Danjovic/CP297s/README.md

# CP297s
ZX97 lite board for CP200s case
