Danjovic/CP297s/CP297s-components-map.pdf

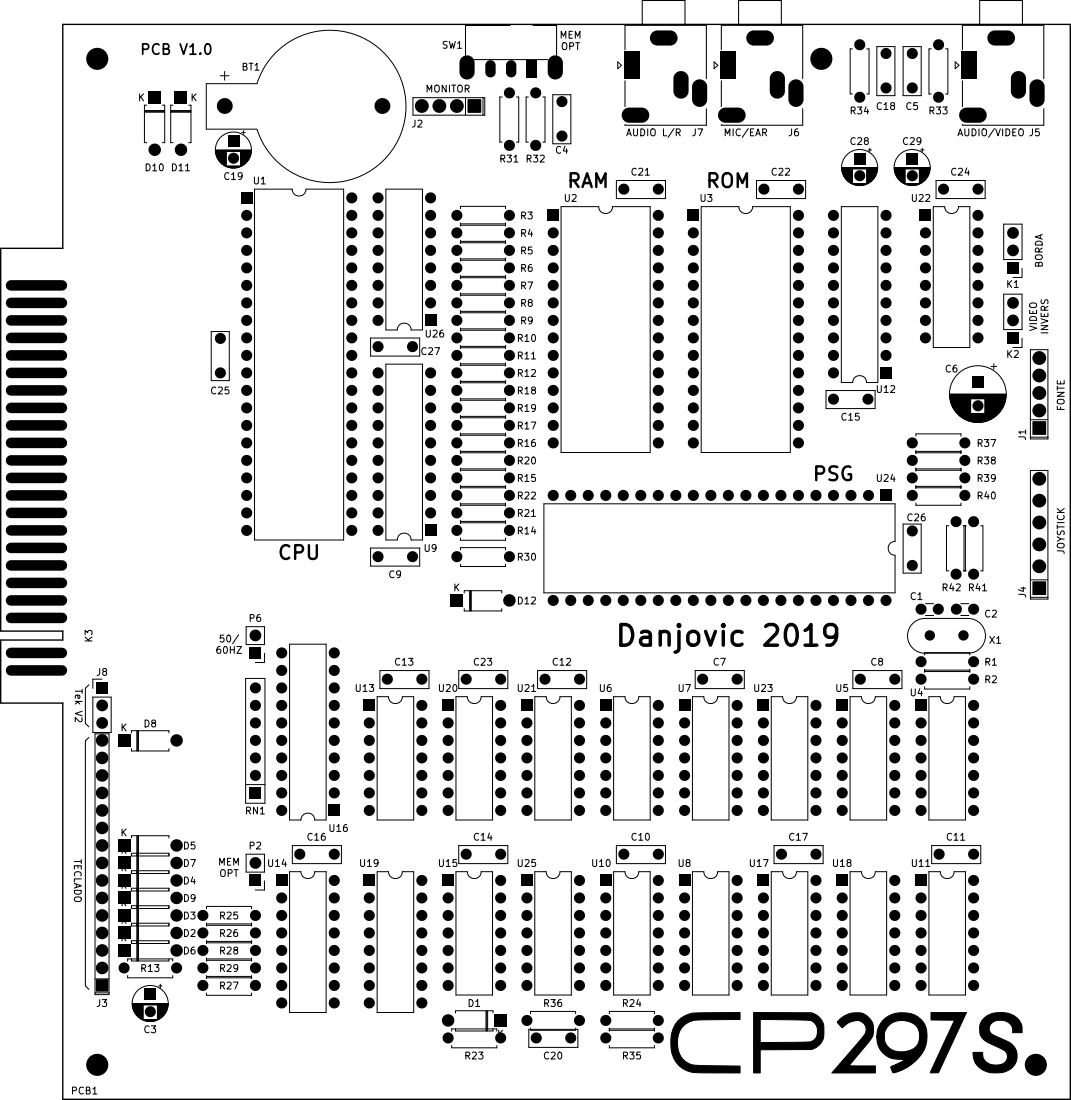
[picture p1: page 1]
