Danjovic/CP297s/CP297s.pdf

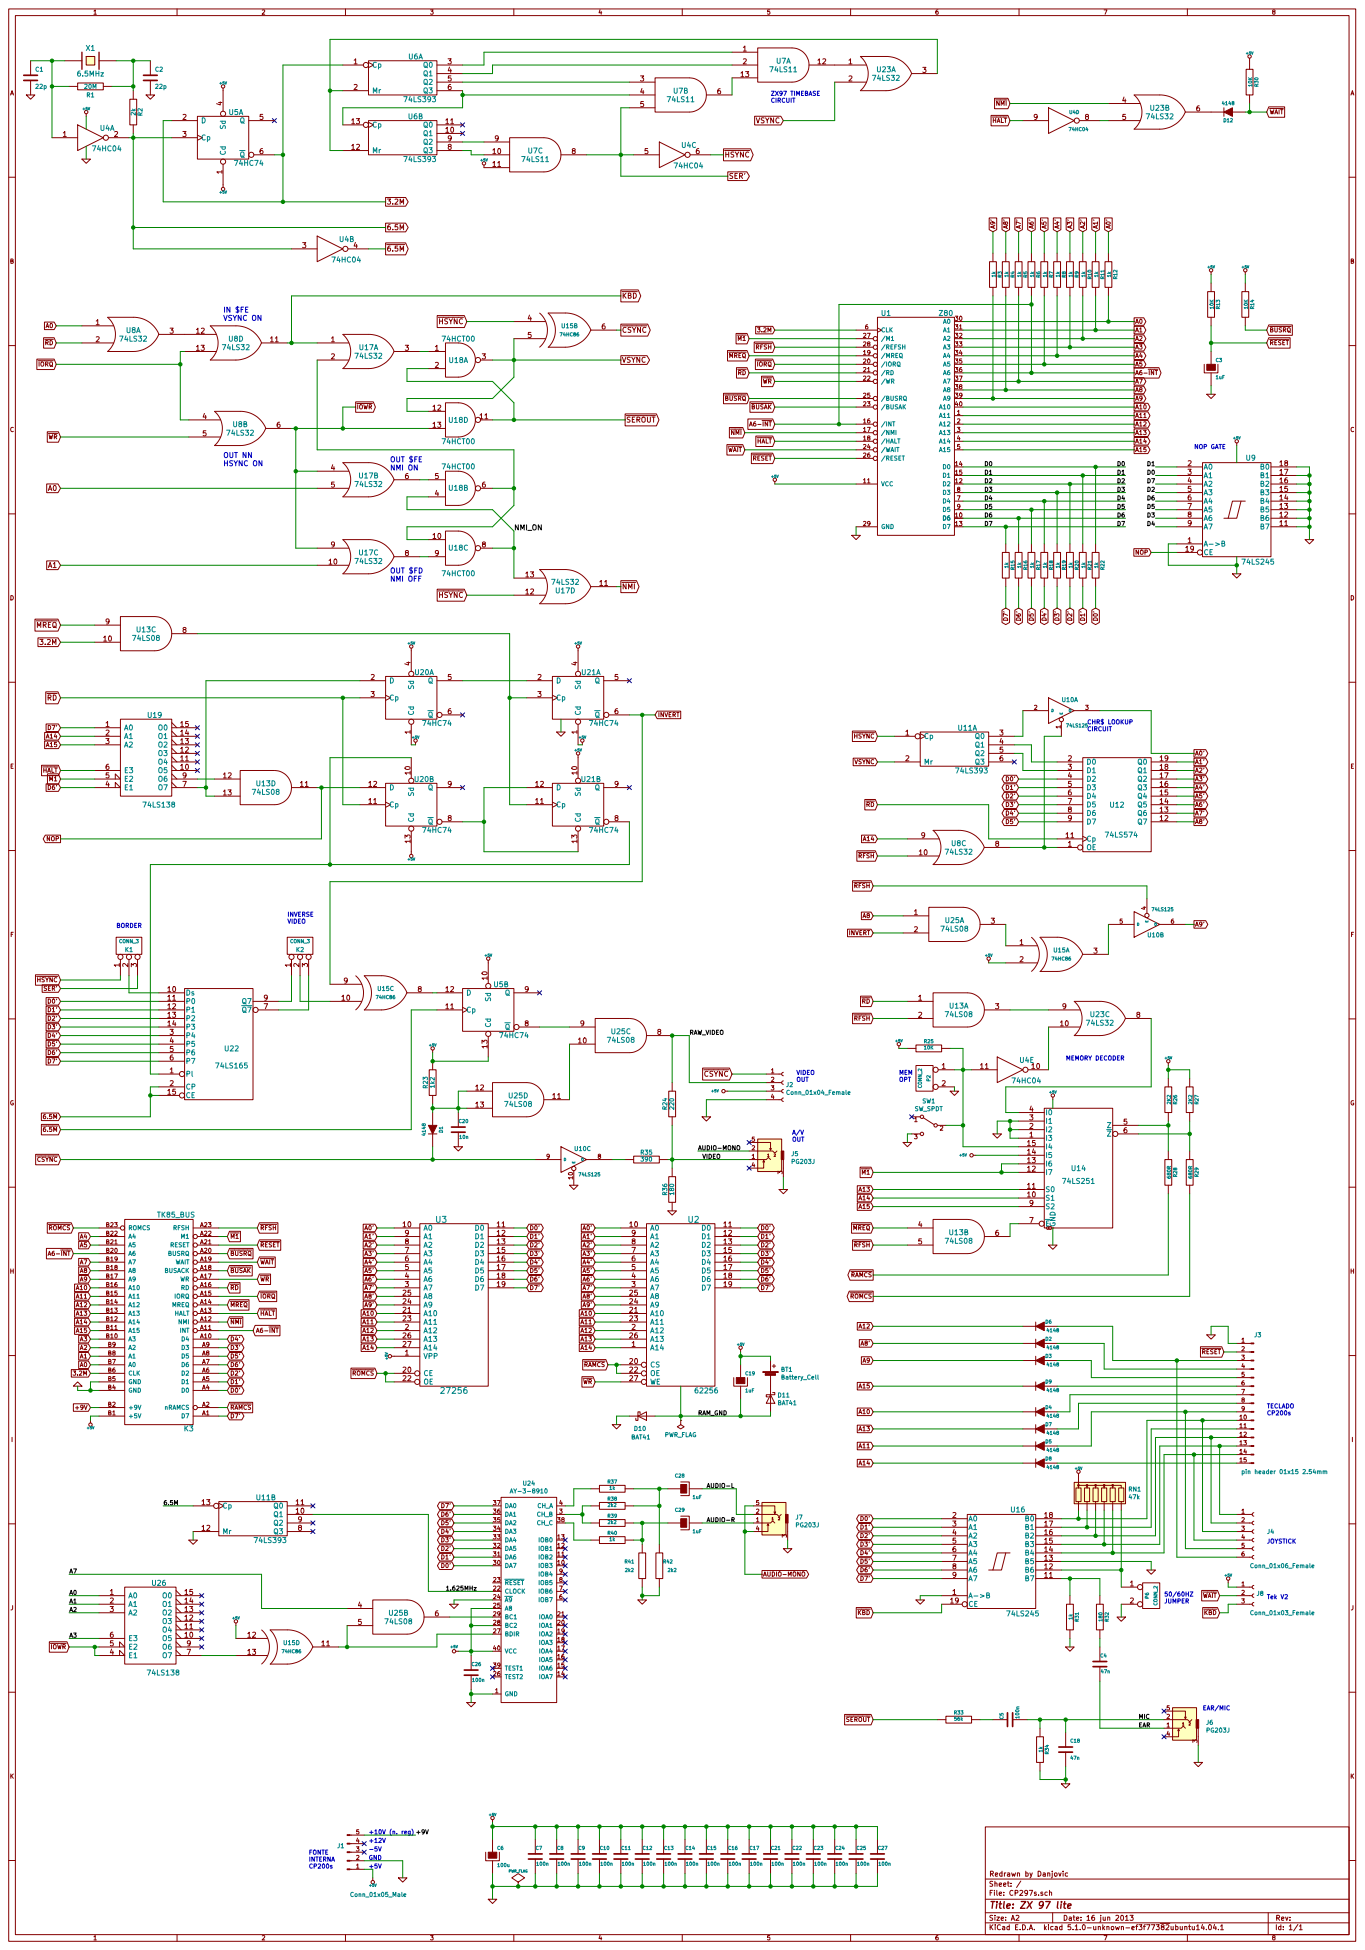
[picture p2: page 1]

File: CP297s.sch Sheet: / Redrawn by Danjovic

Id: 1/1 Title: ZX 97 lite
