Danjovic/CP297s/CP297s.kicad_pcb

## KiCad design CP297s.kicad_pcb (2019-08-31)

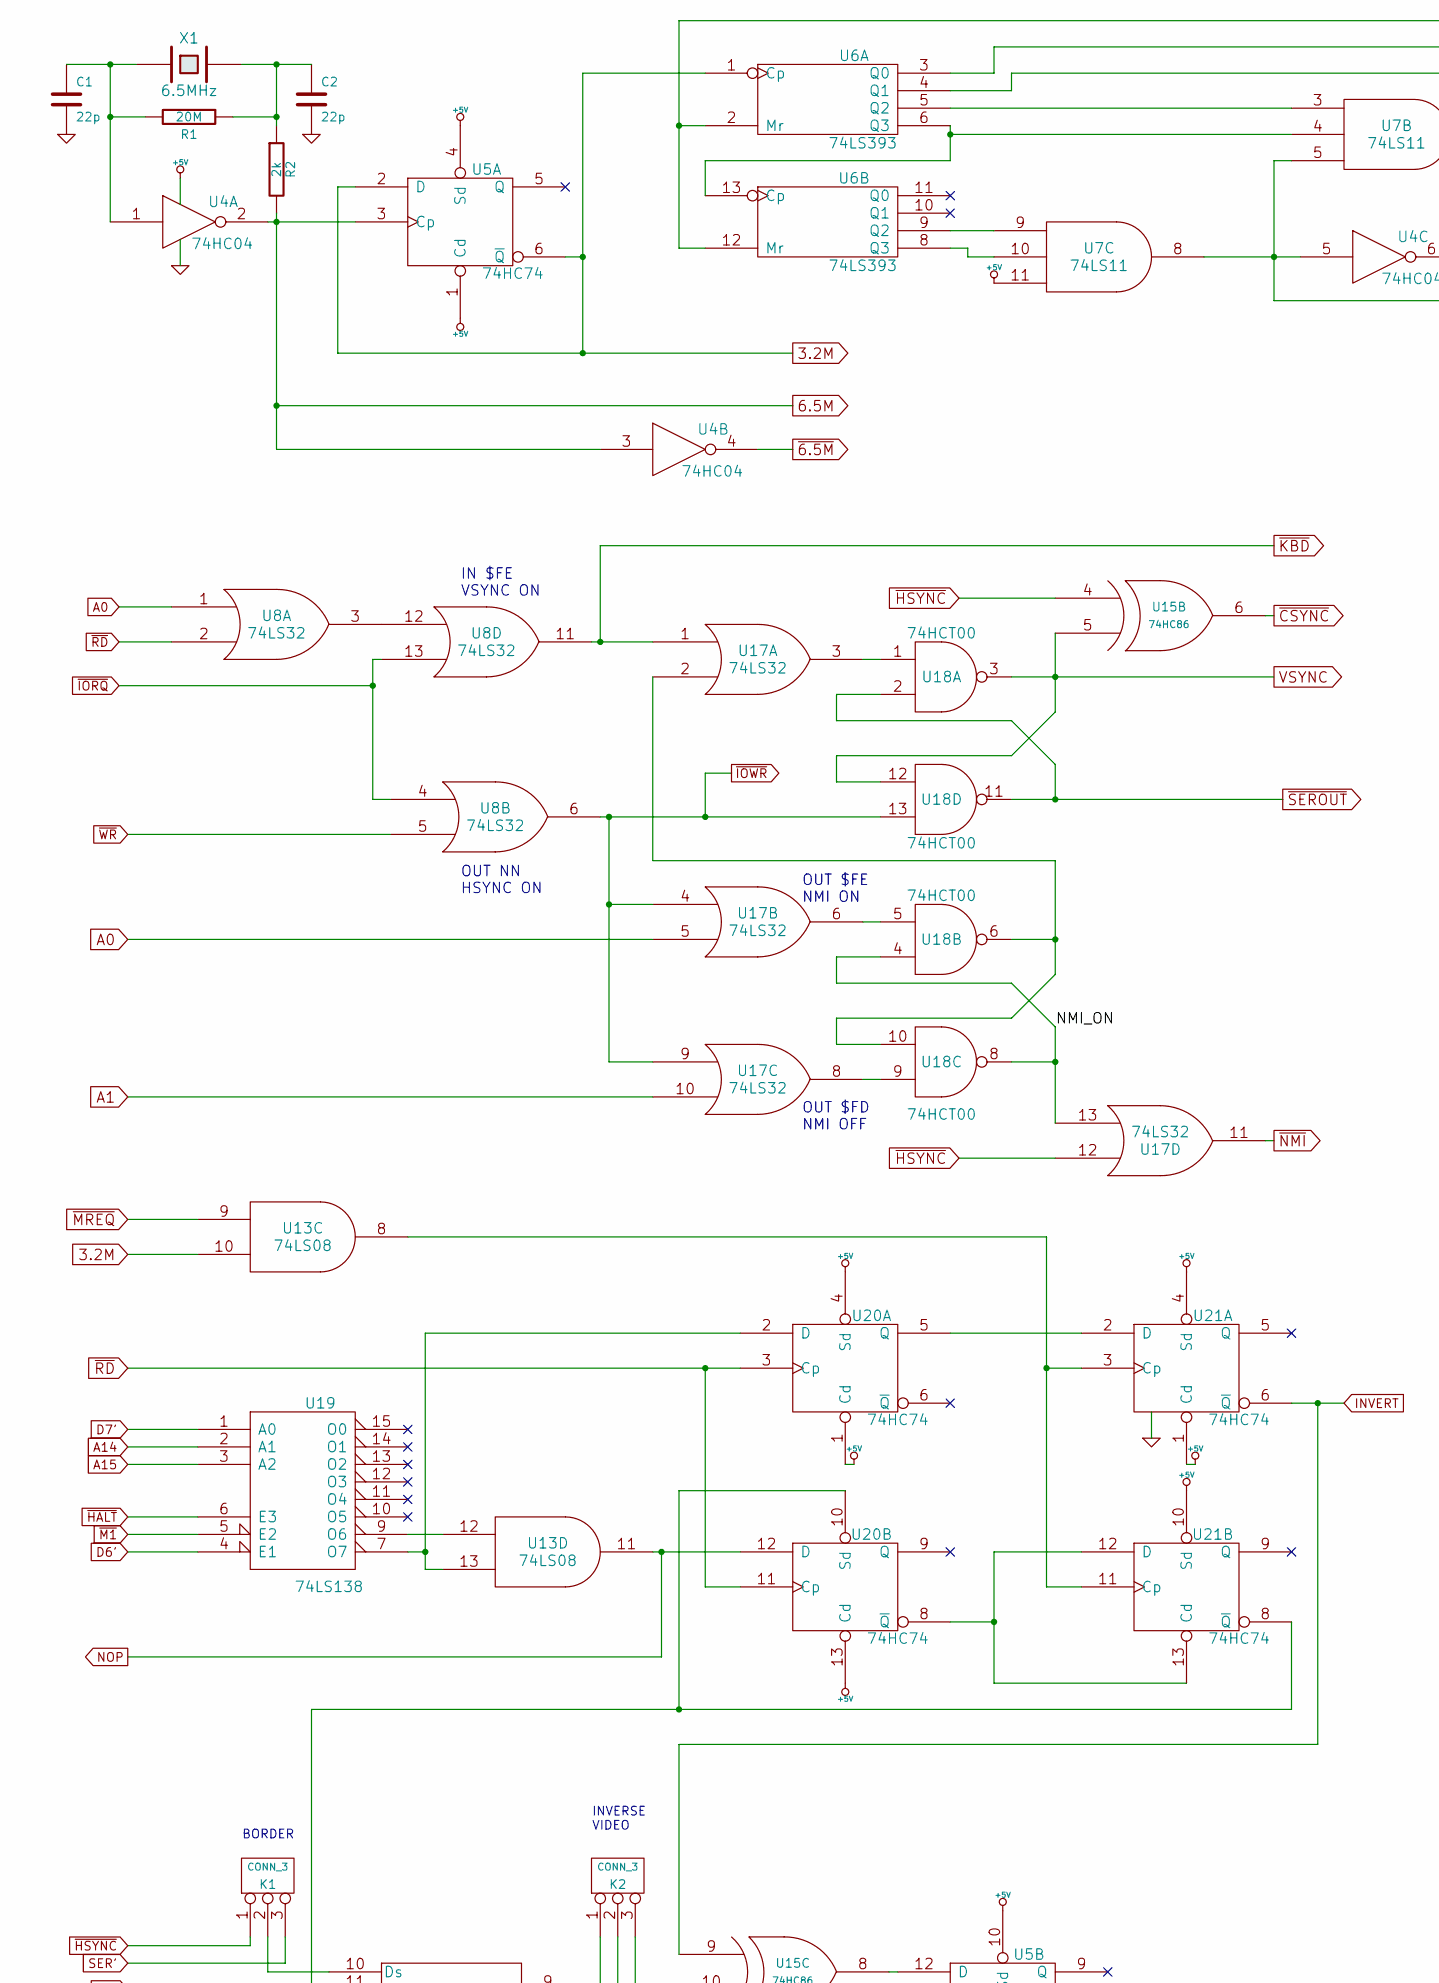
[picture p3: schematic CP297s.sch, ZX 97 lite, part in row 1, column 1]

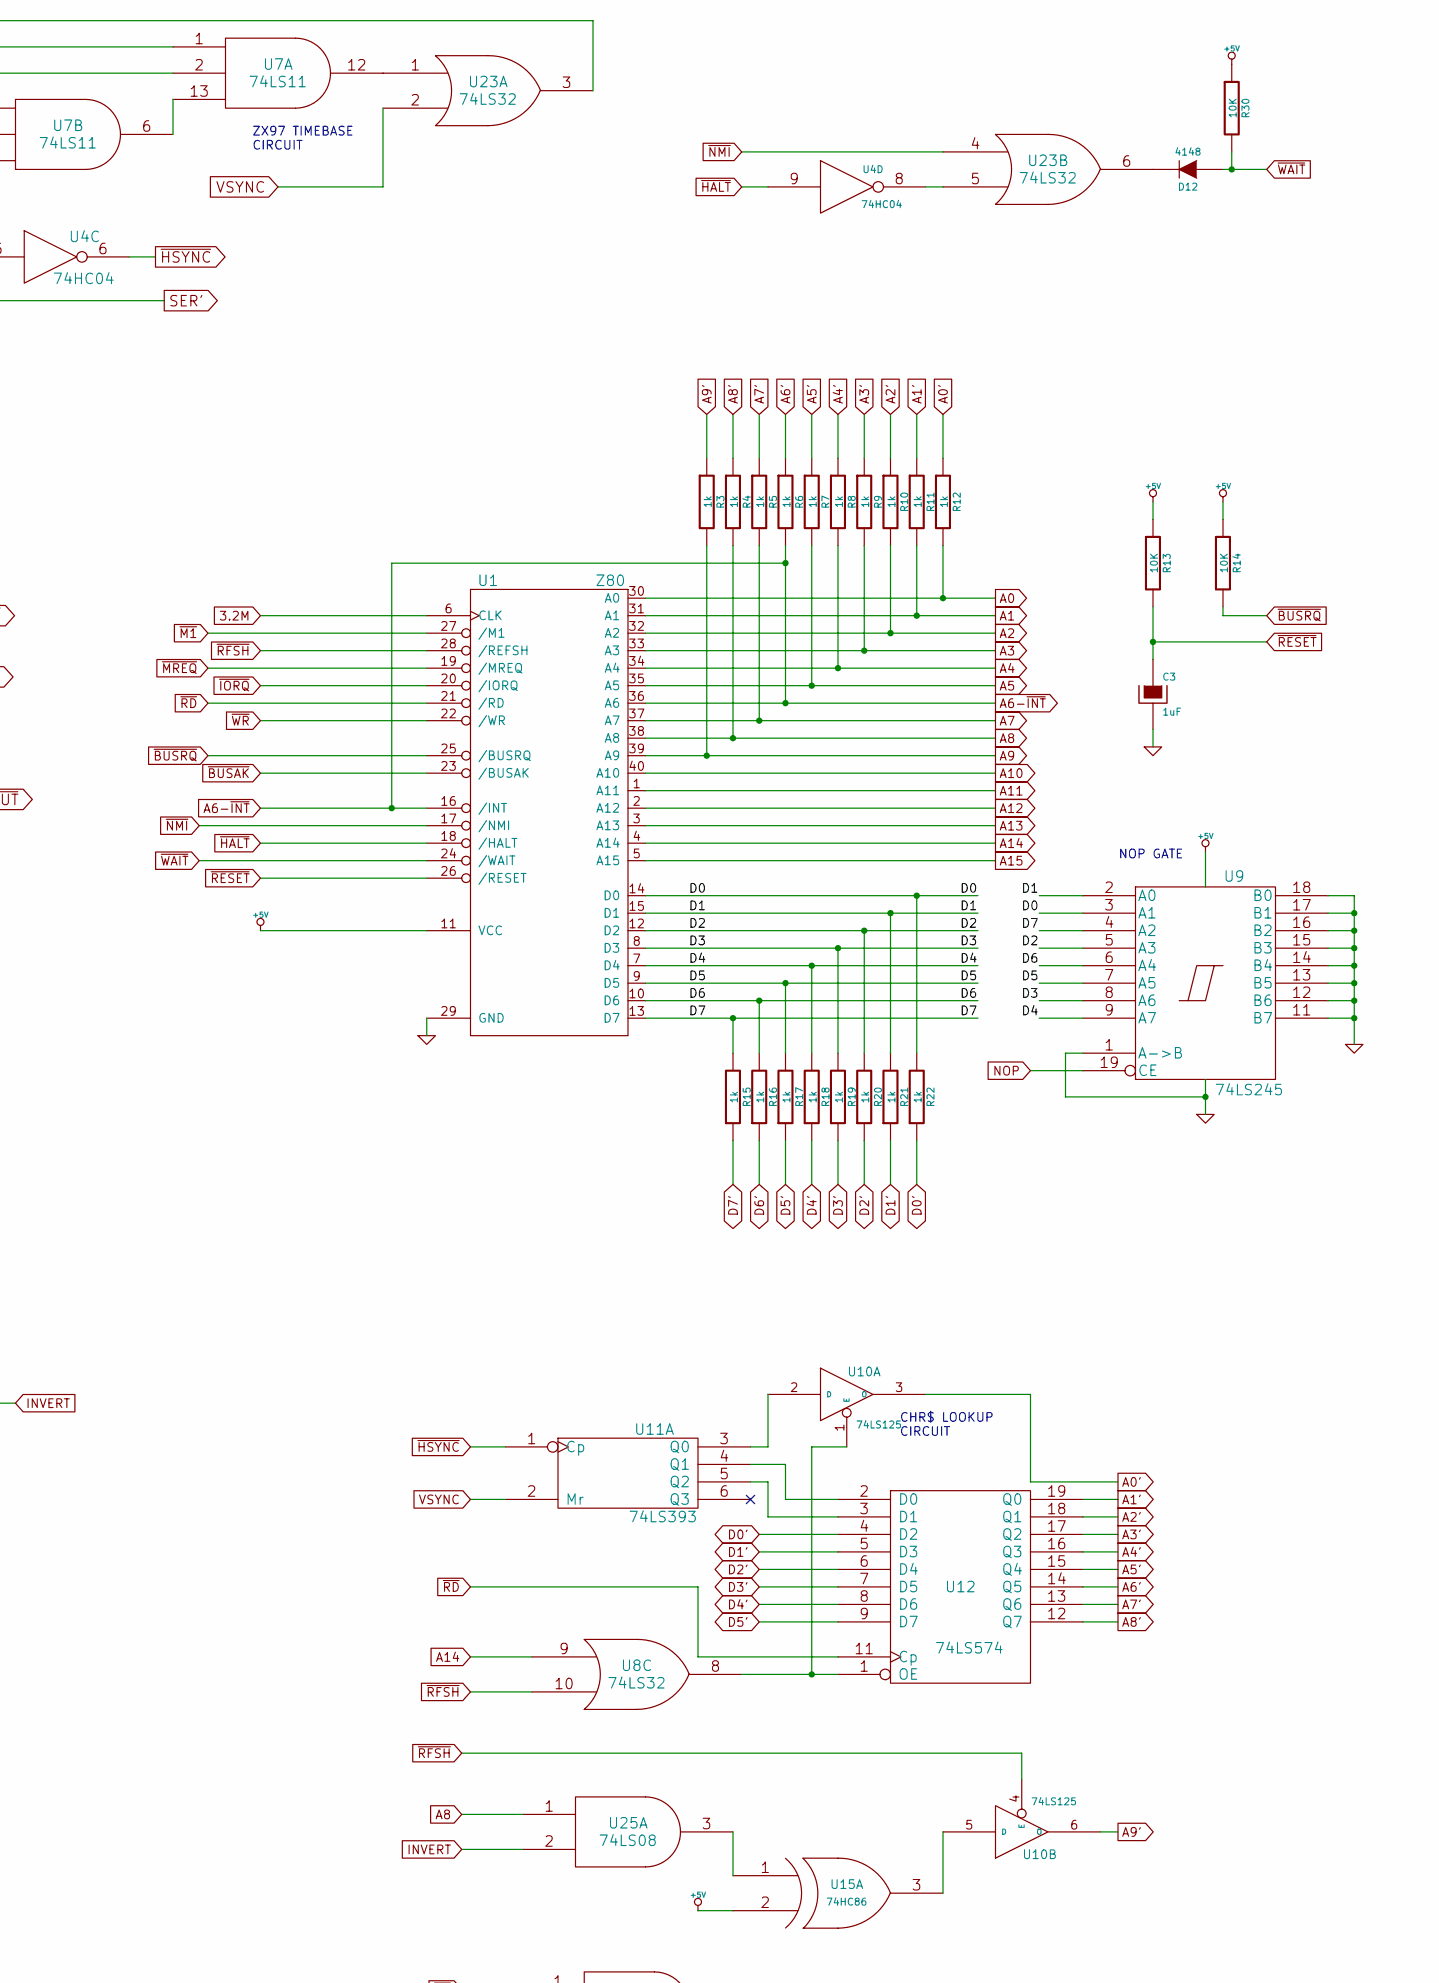
[picture p4: schematic CP297s.sch, ZX 97 lite, part in row 1, column 2]

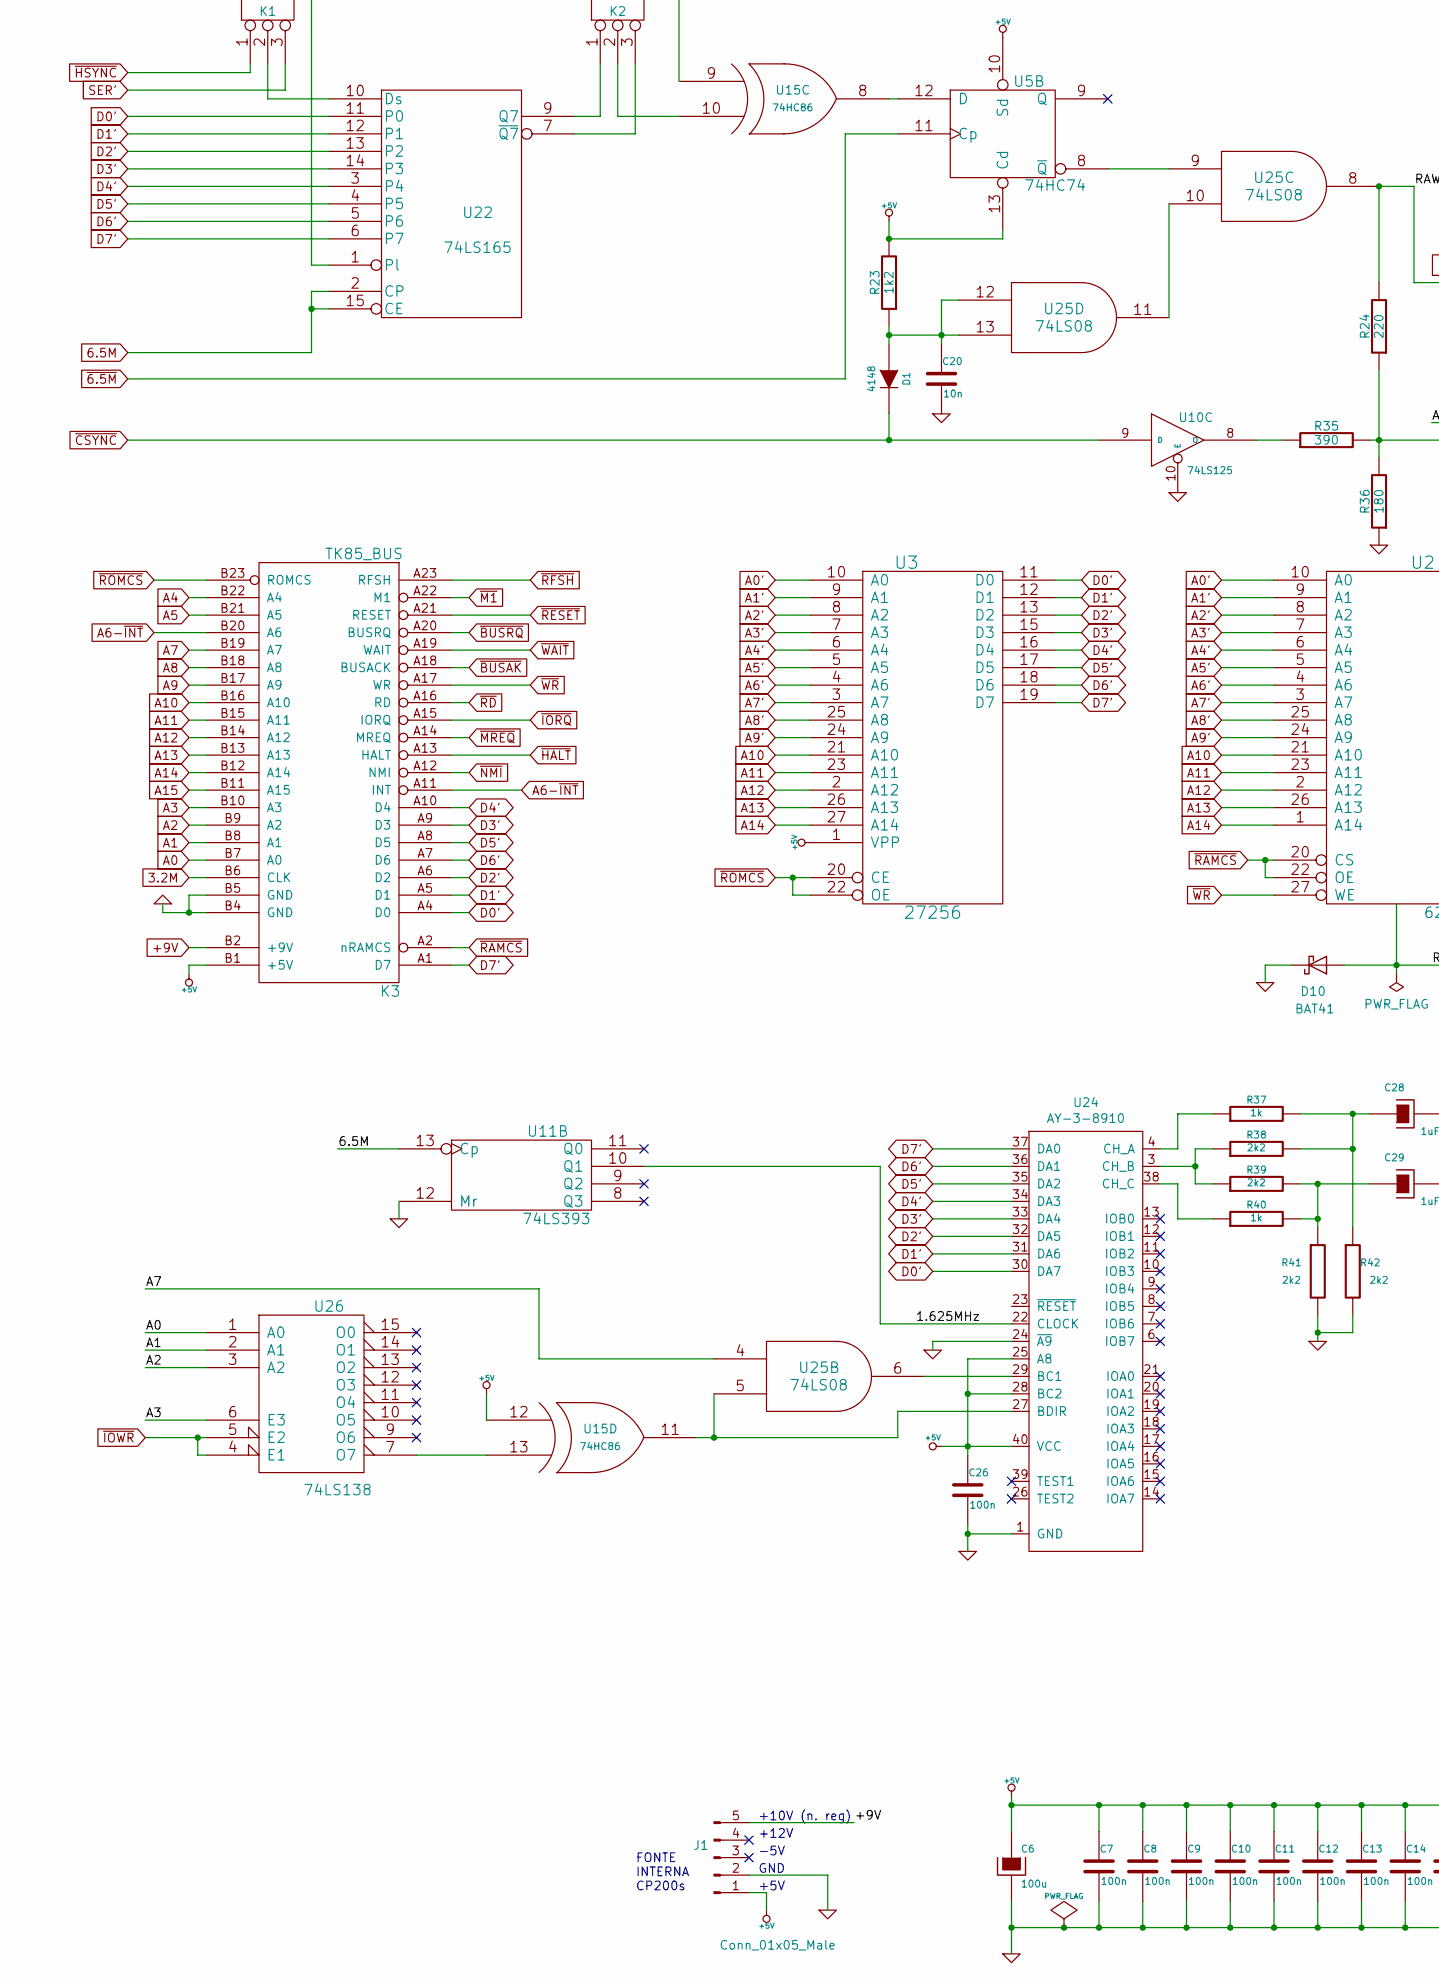
[picture p5: schematic CP297s.sch, ZX 97 lite, part in row 2, column 1]

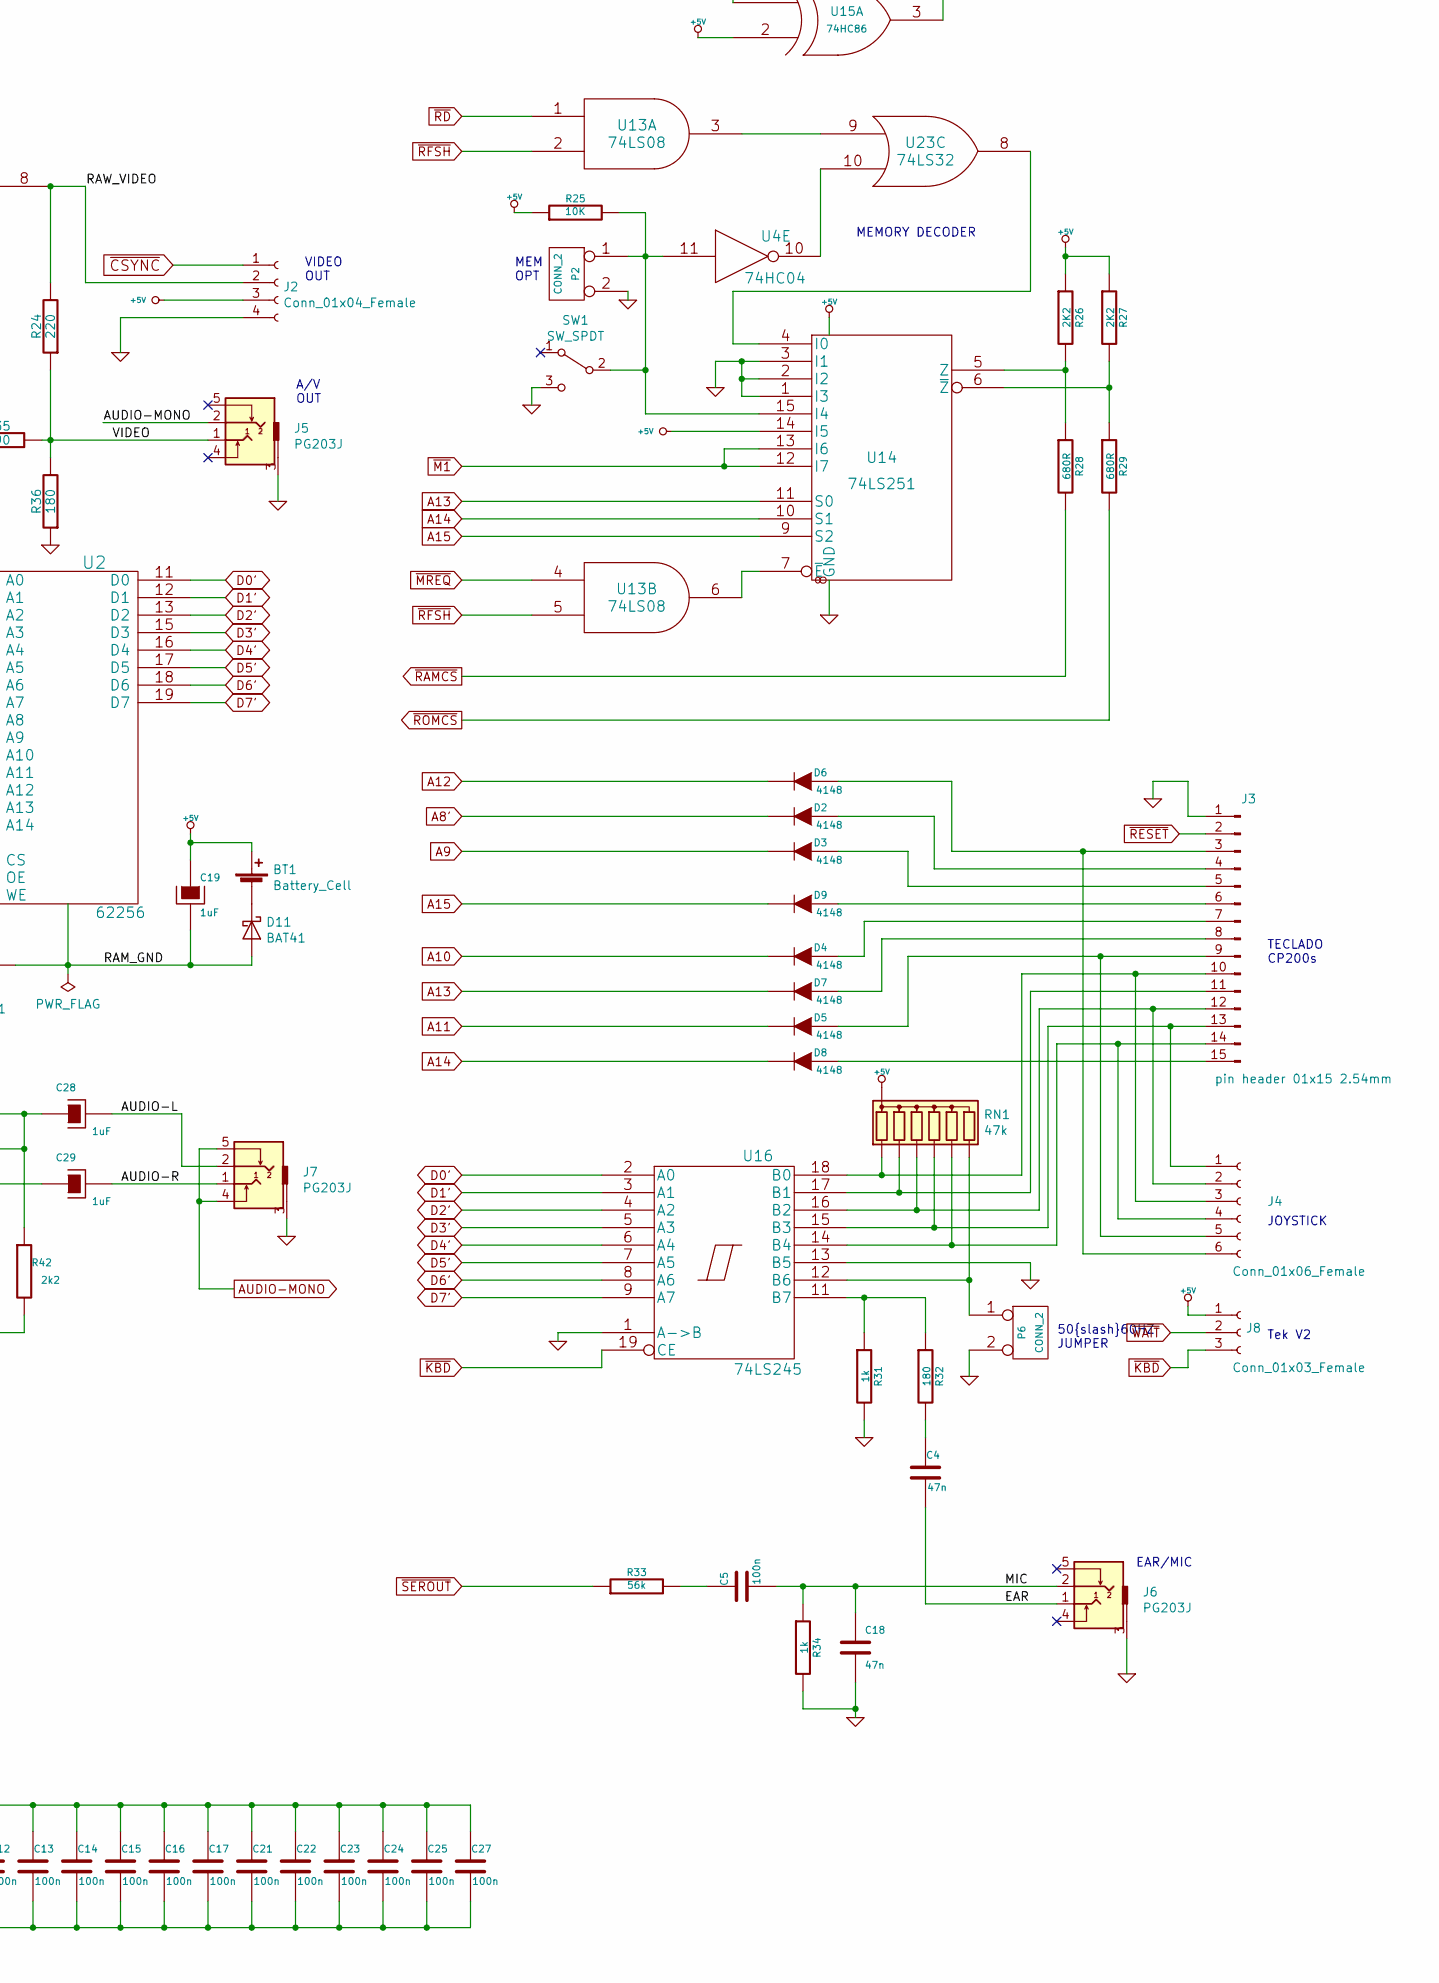
[picture p6: schematic CP297s.sch, ZX 97 lite, part in row 2, column 2]

Parts:
BT1: Battery_Cell; BatteryHolder_CR2032H
C1, C2: 22p; C_Disc_D3.0mm_W1.6mm_P2.50mm
C3, C19, C28, C29: 1uF; CP_Radial_D5.0mm_P2.50mm
C4, C18: 47n; C_Disc_D7.0mm_W2.5mm_P5.00mm
C5, C7, C8, C9, C10, C11, C12, C13, C14, C15, C16, C17, C21, C22, C23, C24, C25, C26, C27: 100n; C_Disc_D7.0mm_W2.5mm_P5.00mm
C6: 100u; CP_Radial_D8.0mm_P3.50mm
C20: 10n; C_Disc_D7.0mm_W2.5mm_P5.00mm
D1, D2, D3, D4, D5, D6, D7, D8, D9, D12: 4148; D_A-405_P7.62mm_Horizontal
D10, D11: BAT41; D_A-405_P7.62mm_Horizontal
J1: Conn_01x05_Male; CP200S_FONTE
J2: Conn_01x04_Female; CP200S_VIDEO
J3: pin header 01x15 2.54mm; CP200s_Keyboard
J4: Conn_01x06_Female; CP200S_JOYSTICK
J5, J6, J7: PG203J
J8: Conn_01x03_Female; PinHeader_1x03_P2.54mm_Vertical
K1, K2: CONN_3; PinHeader_1x03_P2.54mm_Vertical
K3: TK85_BUS; ZX81_EDGE
P2, P6: CONN_2; PinHeader_1x02_P2.54mm_Vertical
R1: 20M; R_Axial_DIN0207_L6.3mm_D2.5mm_P7.62mm_Horizontal
R2: 2k; R_Axial_DIN0207_L6.3mm_D2.5mm_P7.62mm_Horizontal
R3, R4, R5, R6, R7, R8, R9, R10, R11, R12, R15, R16, R17, R18, R19, R20, R21, R22, R31, R34, R37, R40: 1k; R_Axial_DIN0207_L6.3mm_D2.5mm_P7.62mm_Horizontal
R13, R14, R25, R30: 10K; R_Axial_DIN0207_L6.3mm_D2.5mm_P7.62mm_Horizontal
R23: 1k2; R_Axial_DIN0207_L6.3mm_D2.5mm_P7.62mm_Horizontal
R24: 220; R_Axial_DIN0207_L6.3mm_D2.5mm_P7.62mm_Horizontal
R26, R27: 2K2; R_Axial_DIN0207_L6.3mm_D2.5mm_P7.62mm_Horizontal
R28, R29: 680R; R_Axial_DIN0207_L6.3mm_D2.5mm_P7.62mm_Horizontal
R32, R36: 180; R_Axial_DIN0207_L6.3mm_D2.5mm_P7.62mm_Horizontal
R33: 56k; R_Axial_DIN0207_L6.3mm_D2.5mm_P7.62mm_Horizontal
R35: 390; R_Axial_DIN0207_L6.3mm_D2.5mm_P7.62mm_Horizontal
R38, R39, R41, R42: 2k2; R_Axial_DIN0207_L6.3mm_D2.5mm_P7.62mm_Horizontal
RN1: 47k; R_Array_SIP7
SW1: SW_SPDT; SS-12F23_SPDT_Angled
U1: Z80; DIP-40_W15.24mm
U2: 62256; DIP-28_W15.24mm
U3: 27256; DIP-28_W15.24mm
U4: 74HC04; DIP-14_W7.62mm
U5, U20, U21: 74HC74; DIP-14_W7.62mm
U6, U11: 74LS393; DIP-14_W7.62mm
U7: 74LS11; DIP-14_W7.62mm
U8, U17, U23: 74LS32; DIP-14_W7.62mm
U9, U16: 74LS245; DIP-20_W7.62mm
U10: 74LS125; DIP-14_W7.62mm
U12: 74LS574; DIP-20_W7.62mm
U13, U25: 74LS08; DIP-14_W7.62mm
U14: 74LS251; DIP-16_W7.62mm
U15: 74HC86; DIP-14_W7.62mm
U18: 74HCT00; DIP-14_W7.62mm
U19, U26: 74LS138; DIP-16_W7.62mm
U22: 74LS165; DIP-16_W7.62mm
U24: AY-3-8910; DIP-40_W15.24mm
X1: 6.5MHz; Crystal_HC49-U_Vertical

Connections:
3.2M: K3.B6 (CLK), U1.6 (CLK), U5.2 (D), U5.6 (~Q), U6.1 (Cp), U13.10
6.5M: R2.2, U4.2, U4.3, U5.3 (Cp), U22.2 (CP), U22.15 (CE)
+5V: BT1.1 (+), C6.1, C7.1, C8.1, C9.1, C10.1, C11.1, C12.1, C13.1, C14.1, C15.1, C16.1, C17.1, C19.1, C21.1, C22.1, C23.1, C24.1, C25.1, C26.1, C27.1, J1.1, J2.3, J8.1, K3.B1 (+5V), R13.1, R14.1, R23.2, R25.1, R26.1, R27.1, R30.1, RN1.1 (common), U1.11 (VCC), U2.28 (VCC), U3.1 (VPP), U3.28 (VCC), U4.14 (VCC), U5.1 (Cd), U5.4 (Sd), U5.10 (Sd), U5.13 (Cd), U5.14 (VCC), U6.14 (VCC), U7.11, U7.14 (VCC), U8.14 (VCC), U9.20 (VCC), U10.14 (VCC), U11.14 (VCC), U12.20 (VCC), U13.14 (VCC), U14.14 (I5), U14.16 (VCC), U15.2 (IN2), U15.12 (IN1), U15.14 (VCC), U16.20 (VCC), U17.14 (VCC), U18.14 (VCC), U19.16 (VCC), U20.1 (Cd), U20.4 (Sd), U20.13 (Cd), U20.14 (VCC), U21.1 (Cd), U21.4 (Sd), U21.10 (Sd), U21.14 (VCC), U22.16 (VCC), U23.14 (VCC), U24.25 (A8), U24.28 (BC2), U24.40 (VCC), U25.14 (VCC), U26.16 (VCC)
+9V: K3.B2 (+9V)
/1.625MHz: U11.10 (Q1), U24.22 (CLOCK)
/6.5M: U11.13 (Cp)
/+9V: J1.5
/A0: U26.1 (A0)
/A1: U26.2 (A1)
/A2: U26.3 (A2)
/A3: U26.6 (E3)
/A7: U25.4
/AUDIO-L: C28.2, J7.2
/AUDIO-MONO: J5.2
/AUDIO-R: C29.2, J7.1
/D0: R22.2, U1.14 (D0), U9.3 (A1)
/D1: R21.2, U1.15 (D1), U9.2 (A0)
/D2: R20.2, U1.12 (D2), U9.5 (A3)
/D3: R19.2, U1.8 (D3), U9.8 (A6)
/D4: R18.2, U1.7 (D4), U9.9 (A7)
/D5: R17.2, U1.9 (D5), U9.7 (A5)
/D6: R16.2, U1.10 (D6), U1.~ (D6), U9.6 (A4)
/D7: R15.2, U1.13 (D7), U9.4 (A2)
/EAR: C4.2, J6.1
/MIC: C5.2, C18.2, J6.2, R34.1
/NMI_ON: U17.13, U18.4, U18.8
/RAW_VIDEO: J2.2, R24.2, U25.8
/VIDEO: J5.1, R24.1, R35.2, R36.2
A0: K3.B7 (A0), R12.2, U1.30 (A0), U8.1, U17.5
A0': R12.1, U2.10 (A0), U3.10 (A0), U10.3 (O)
A1: K3.B8 (A1), R11.2, U1.31 (A1), U17.10
A1': R11.1, U2.9 (A1), U3.9 (A1), U12.19 (Q0)
A2: K3.B9 (A2), R10.2, U1.32 (A2)
A2': R10.1, U2.8 (A2), U3.8 (A2), U12.18 (Q1)
A3: K3.B10 (A3), R9.2, U1.33 (A3)
A3': R9.1, U2.7 (A3), U3.7 (A3), U12.17 (Q2)
A4: K3.B22 (A4), R8.2, U1.34 (A4)
A4': R8.1, U2.6 (A4), U3.6 (A4), U12.16 (Q3)
A5: K3.B21 (A5), R7.2, U1.35 (A5)
A5': R7.1, U2.5 (A5), U3.5 (A5), U12.15 (Q4)
A6': R6.1, U2.4 (A6), U3.4 (A6), U12.14 (Q5)
A6-~INT: K3.A11 (INT), K3.B20 (A6), R6.2, U1.16 (/INT), U1.36 (A6)
A7: K3.B19 (A7), R5.2, U1.37 (A7)
A7': R5.1, U2.3 (A7), U3.3 (A7), U12.13 (Q6)
A8: K3.B18 (A8), R4.2, U1.38 (A8), U25.1
A8': D2.2 (K), R4.1, U2.25 (A8), U3.25 (A8), U12.12 (Q7)
A9: D3.2 (K), K3.B17 (A9), R3.2, U1.39 (A9)
A9': R3.1, U2.24 (A9), U3.24 (A9), U10.6 (O)
A10: D4.2 (K), K3.B16 (A10), U1.40 (A10), U2.21 (A10), U3.21 (A10)
A11: D5.2 (K), K3.B15 (A11), U1.1 (A11), U2.23 (A11), U3.23 (A11)
A12: D6.2 (K), K3.B14 (A12), U1.2 (A12), U2.2 (A12), U3.2 (A12)
A13: D7.2 (K), K3.B13 (A13), U1.3 (A13), U2.26 (A13), U3.26 (A13), U14.11 (S0)
A14: D8.2 (K), K3.B12 (A14), U1.4 (A14), U2.1 (A14), U3.27 (A14), U8.9, U14.10 (S1), U19.2 (A1)
A15: D9.2 (K), K3.B11 (A15), U1.5 (A15), U14.9 (S2), U19.3 (A2)
AUDIO-MONO: J7.4, J7.5
D0': K3.A4 (D0), R22.1, U2.11 (D0), U3.11 (D0), U12.4 (D2), U16.2 (A0), U22.11 (P0), U24.30 (DA7)
D1': K3.A5 (D1), R21.1, U2.12 (D1), U3.12 (D1), U12.5 (D3), U16.3 (A1), U22.12 (P1), U24.31 (DA6)
D2': K3.A6 (D2), R20.1, U2.13 (D2), U3.13 (D2), U12.6 (D4), U16.4 (A2), U22.13 (P2), U24.32 (DA5)
D3': K3.A9 (D3), R19.1, U2.15 (D3), U3.15 (D3), U12.7 (D5), U16.5 (A3), U22.14 (P3), U24.33 (DA4)
D4': K3.A10 (D4), R18.1, U2.16 (D4), U3.16 (D4), U12.8 (D6), U16.6 (A4), U22.3 (P4), U24.34 (DA3)
D5': K3.A8 (D5), R17.1, U2.17 (D5), U3.17 (D5), U12.9 (D7), U16.7 (A5), U22.4 (P5), U24.35 (DA2)
D6': K3.A7 (D6), R16.1, U2.18 (D6), U3.18 (D6), U16.8 (A6), U19.4 (E1), U22.5 (P6), U24.36 (DA1)
D7': K3.A1 (D7), R15.1, U2.19 (D7), U3.19 (D7), U16.9 (A7), U19.1 (A0), U22.6 (P7), U24.37 (DA0)
GND: C1.2, C2.2, C3.2, C6.2, C7.2, C8.2, C9.2, C10.2, C11.2, C12.2, C13.2, C14.2, C15.2, C16.2, C17.2, C18.1, C20.2, C21.2, C22.2, C23.2, C24.2, C25.2, C26.2, C27.2, D10.1 (K), J1.2, J2.4, J3.1, J5.3, J6.3, J7.3, K3.B4 (GND), K3.B5 (GND), P2.2 (PM), P6.2 (PM), R31.2, R34.2, R36.1, R41.2, R42.2, SW1.3 (C), U1.29 (GND), U3.14 (GND), U4.7 (GND), U5.7 (GND), U6.7 (GND), U7.7 (GND), U8.7 (GND), U9.1 (A->B), U9.10 (GND), U9.11 (B7), U9.12 (B6), U9.13 (B5), U9.14 (B4), U9.15 (B3), U9.16 (B2), U9.17 (B1), U9.18 (B0), U10.7 (GND), U10.10 (E), U11.7 (GND), U11.12 (Mr), U12.10 (GND), U13.7 (GND), U14.1 (I3), U14.2 (I2), U14.3 (I1), U14.8 (GND), U15.7 (GND), U16.1 (A->B), U16.10 (GND), U16.13 (B5), U17.7 (GND), U18.7 (GND), U19.8 (GND), U20.7 (GND), U21.7 (GND), U22.8 (GND), U23.7 (GND), U24.1 (GND), U24.24 (~A9), U25.7 (GND), U26.8 (GND)
INVERT: U15.9 (IN1), U21.6 (~Q), U25.2
NOP: U9.19 (CE), U13.11, U20.12 (D)
unnamed: BT1.2 (-), D11.1 (K)
unnamed: C1.1, R1.2, U4.1, X1.1
unnamed: C2.1, R1.1, R2.1, X1.2
unnamed: C4.1, R32.2
unnamed: C5.1, R33.2
unnamed: C20.1, D1.1 (A), R23.1, U25.12, U25.13
unnamed: C28.1, R37.2, R38.2, R42.1
unnamed: C29.1, R39.2, R40.2, R41.1
unnamed: D2.1 (A), J3.4
unnamed: D3.1 (A), J3.5
unnamed: D4.1 (A), J3.7
unnamed: D5.1 (A), J3.9, J4.5
unnamed: D6.1 (A), J3.3, J4.6
unnamed: D7.1 (A), J3.8
unnamed: D8.1 (A), J3.15
unnamed: D9.1 (A), J3.6
unnamed: D12.2 (K), U23.6
unnamed: J3.10, J4.3, RN1.2 (R1), U16.18 (B0)
unnamed: J3.11, RN1.3 (R2), U16.17 (B1)
unnamed: J3.12, J4.2, RN1.4 (R3), U16.16 (B2)
unnamed: J3.13, J4.1, RN1.5 (R4), U16.15 (B3)
unnamed: J3.14, J4.4, RN1.6 (R5), U16.14 (B4)
unnamed: K1.2 (PM), U22.10 (Ds)
unnamed: K2.1, U22.9 (Q7)
unnamed: K2.2 (PM), U15.10 (IN2)
unnamed: K2.3, U22.7 (~Q7)
unnamed: P2.1, R25.2, SW1.2 (B), U4.11, U14.15 (I4)
unnamed: P6.1, RN1.7 (R6), U16.12 (B6)
unnamed: R26.2, R28.1, U14.5 (Z)
unnamed: R27.2, R29.1, U14.6 (~Z)
unnamed: R31.1, R32.1, U16.11 (B7)
unnamed: R35.1, U10.8 (O)
unnamed: R37.1, U24.4 (CH_A)
unnamed: R38.1, R39.1, U24.3 (CH_B)
unnamed: R40.1, U24.38 (CH_C)
unnamed: U6.3 (Q0), U7.1
unnamed: U6.4 (Q1), U7.2
unnamed: U6.5 (Q2), U7.3
unnamed: U6.8 (Q3), U7.10
unnamed: U6.9 (Q2), U7.9
unnamed: U6.6 (Q3), U6.13 (Cp), U7.4
unnamed: U7.6, U7.13
unnamed: U8.3, U8.12
unnamed: U8.8, U10.1 (E), U12.1 (OE)
unnamed: U10.2 (D), U11.3 (Q0)
unnamed: U10.5 (D), U15.3 (OUT)
unnamed: U11.4 (Q1), U12.2 (D0)
unnamed: U11.5 (Q2), U12.3 (D1)
unnamed: U13.3, U23.9
unnamed: U13.6, U14.7 (~E)
unnamed: U13.8, U21.3 (Cp), U21.11 (Cp)
unnamed: U13.12, U19.9 (O6)
unnamed: U13.13, U19.7 (O7), U20.2 (D)
unnamed: U14.4 (I0), U23.8
unnamed: U15.1 (IN1), U25.3
unnamed: U5.12 (D), U15.8 (OUT)
unnamed: U15.11 (OUT), U24.27 (BDIR), U25.5
unnamed: U15.13 (IN2), U26.7 (O7)
unnamed: U17.2, U18.6, U18.10
unnamed: U17.3, U18.1
unnamed: U17.6, U18.5
unnamed: U17.8, U18.9
unnamed: U20.5 (Q), U21.2 (D)
unnamed: U20.8 (~Q), U21.12 (D), U21.13 (Cd)
unnamed: U20.10 (Sd), U21.8 (~Q), U22.1 (Pl)
unnamed: U7.12, U23.1
unnamed: U6.2 (Mr), U6.12 (Mr), U23.3
unnamed: U4.8, U23.5
unnamed: U4.10, U23.10
unnamed: U24.29 (BC1), U25.6
unnamed: U5.8 (~Q), U25.9
unnamed: U25.10, U25.11
SER': K1.3, U4.5, U7.5, U7.8
VSYNC: U11.2 (Mr), U15.5 (IN2), U18.3, U18.12, U23.2
~: C19.2, D10.2 (A), D11.2 (A), U2.14
~6.5M: U4.4, U5.11 (Cp)
~BUSAK: K3.A18 (BUSACK), U1.23 (/BUSAK)
~BUSRQ: K3.A20 (BUSRQ), R14.2, U1.25 (/BUSRQ)
~CSYNC: D1.2 (K), J2.1, U10.9 (D), U15.6 (OUT)
~HALT: K3.A13 (HALT), U1.18 (/HALT), U4.9, U19.6 (E3)
~HSYNC: K1.1, U4.6, U11.1 (Cp), U15.4 (IN1), U17.12
~IORQ: K3.A15 (IORQ), U1.20 (/IORQ), U8.4, U8.13
~IOWR: U8.6, U17.4, U17.9, U18.13, U26.4 (E1), U26.5 (E2)
~KBD: J8.3, U8.11, U16.19 (CE), U17.1
~M1: K3.A22 (M1), U1.27 (/M1), U14.12 (I7), U14.13 (I6), U19.5 (E2)
~MREQ: K3.A14 (MREQ), U1.19 (/MREQ), U13.4, U13.9
~NMI: K3.A12 (NMI), U1.17 (/NMI), U17.11, U23.4
~RAMCS: K3.A2 (nRAMCS), R28.2, U2.20 (CS), U2.22 (OE)
~RD: K3.A16 (RD), U1.21 (/RD), U8.2, U12.11 (Cp), U13.1, U20.3 (Cp), U20.11 (Cp)
~RESET: C3.1, J3.2, K3.A21 (RESET), R13.2, U1.26 (/RESET)
~RFSH: K3.A23 (RFSH), U1.28 (/REFSH), U8.10, U10.4 (E), U13.2, U13.5
~ROMCS: K3.B23 (ROMCS), R29.2, U3.20 (CE), U3.22 (OE)
~SEROUT: R33.1, U18.2, U18.11
~WAIT: D12.1 (A), J8.2, K3.A19 (WAIT), R30.2, U1.24 (/WAIT)
~WR: K3.A17 (WR), U1.22 (/WR), U2.27 (WE), U8.5

Notes on the sheet:
IN $FE VSYNC ON
OUT NN HSYNC ON
OUT $FE NMI ON
OUT $FD NMI OFF
CHR$ LOOKUP CIRCUIT
NOP GATE
ZX97 TIMEBASE CIRCUIT
MEMORY DECODER
MEM OPT
INVERSE VIDEO
50{slash}60HZ JUMPER
EAR/MIC
VIDEO OUT
JOYSTICK
TECLADO CP200s
FONTE INTERNA CP200s
+10V (n. reg)
+12V
-5V
GND
+5V
A/V OUT
BORDER
Tek V2

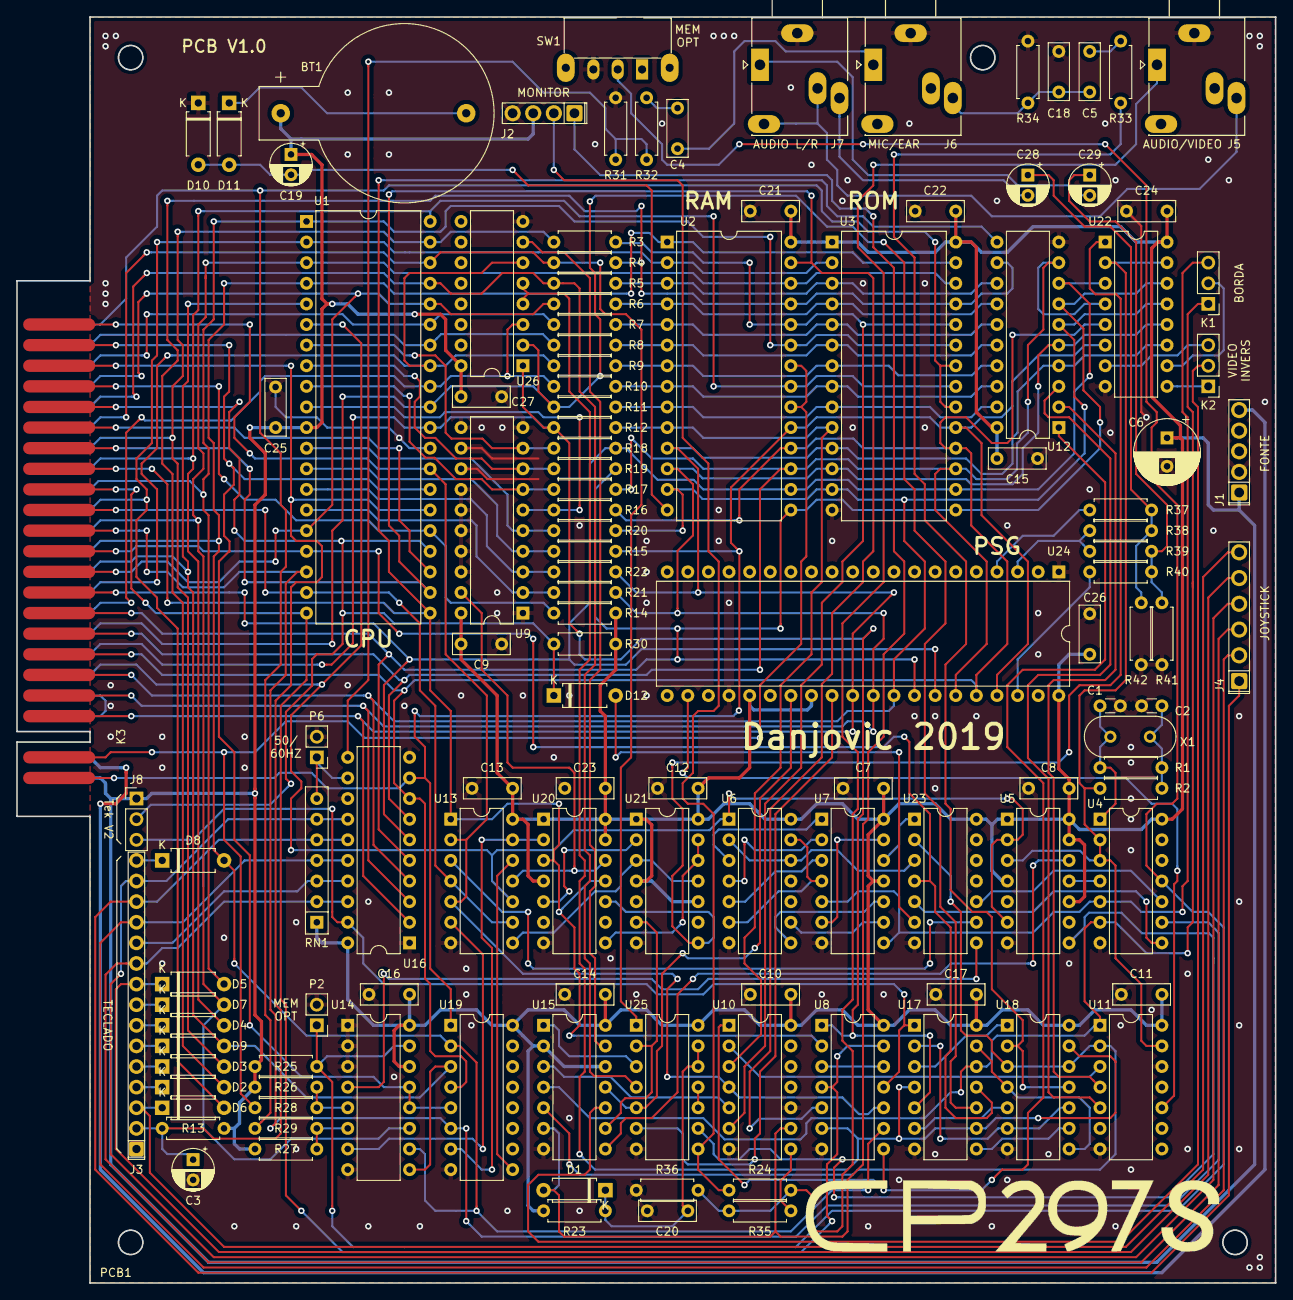
[picture p7: board CP297s.kicad_pcb from above]

Board: 2 copper layers, 155.1 x 156.0 mm, 127 parts (0 on the bottom side), 152 nets.

Other parts of the board:
PCB1: Placa_CP200S
