Danjovic/CP297s/(commit log)

2019-07-03 updated pcb layout, added logo
    [CP297s.kicad_pcb]
2019-07-08 add PSG, changed AV connectors
    [CP297s.kicad_pcb, CP297s.sch]
2019-07-13 moved battery clip, substituted audio-mono for +5Vcc at MONITOR OUT connector
    [CP297s.kicad_pcb, CP297s.sch]
2019-07-23 updated board outline, support for external kolour
    [CP297s.kicad_pcb, CP297s.sch]
2019-08-07 Added resistor network at keyboard inputs
    [CP297s.kicad_pcb, CP297s.sch]
2019-08-07 added revision version in top silk
    [CP297s.kicad_pcb]
2019-08-08 fixed CPU syncrhonizer (/wait logic)
    [CP297s.kicad_pcb, CP297s.sch]
2019-08-11 Added header for Tek V2
    [CP297s.kicad_pcb, CP297s.sch]
2019-08-31 Aesthetic improvement, gerbers added
    [CP297s.kicad_pcb, CP297s.sch]
2019-10-12 added schematic in PDF and BOM in csv
    [CP297s-bom.csv]
2019-10-22 Added components map on the board
